Meshtastic-Malaysia/russell/README.md

# Russell

Russell is a board designed to mount on an ER34615/IFR32700 cell and go Up! on a balloon.

- RAK3172 STM32WLE5CCU6 MCU + integrated SX1262 LoRa
- CDtop CD-PA1010D GPS
- Bosch Sensortec BME280 sensor
- Consonance CN3158 LiFePO4 solar charger
