Meshtastic-Malaysia/russell/3dmodels/SHOU HAN TS36CA-0.6_v1.step

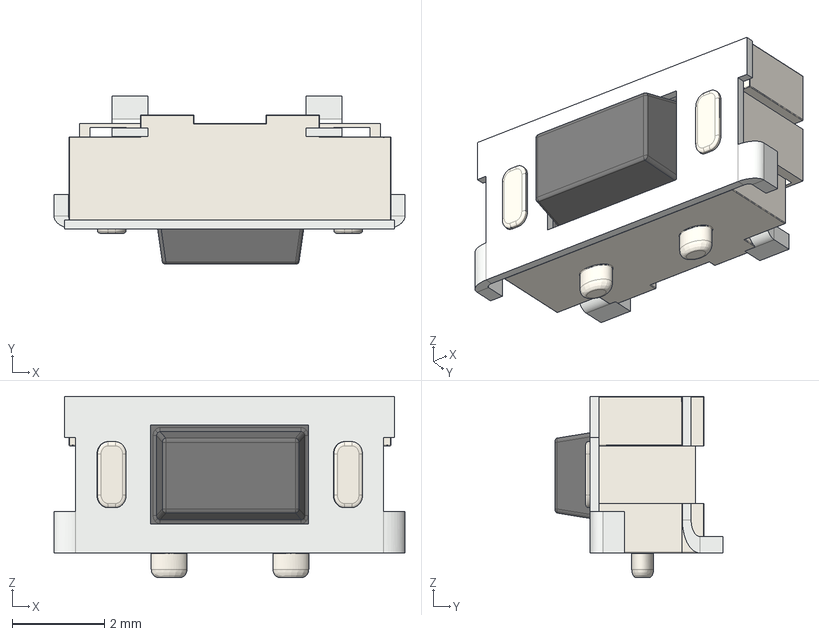
[picture p1: CAD file, 2025-12-26]
3dmodels/SHOU HAN TS36CA-0.6_v1.step
7.60 x 3.64 x 3.93 mm
xiaobeibei_body
xiaobeibei_cap
xiaobeibei_plate
xiaobeibei_pin x 2
