Meshtastic-Malaysia/russell/3dmodels/CD-PA1010D--3DModel-STEP-271329.STEP

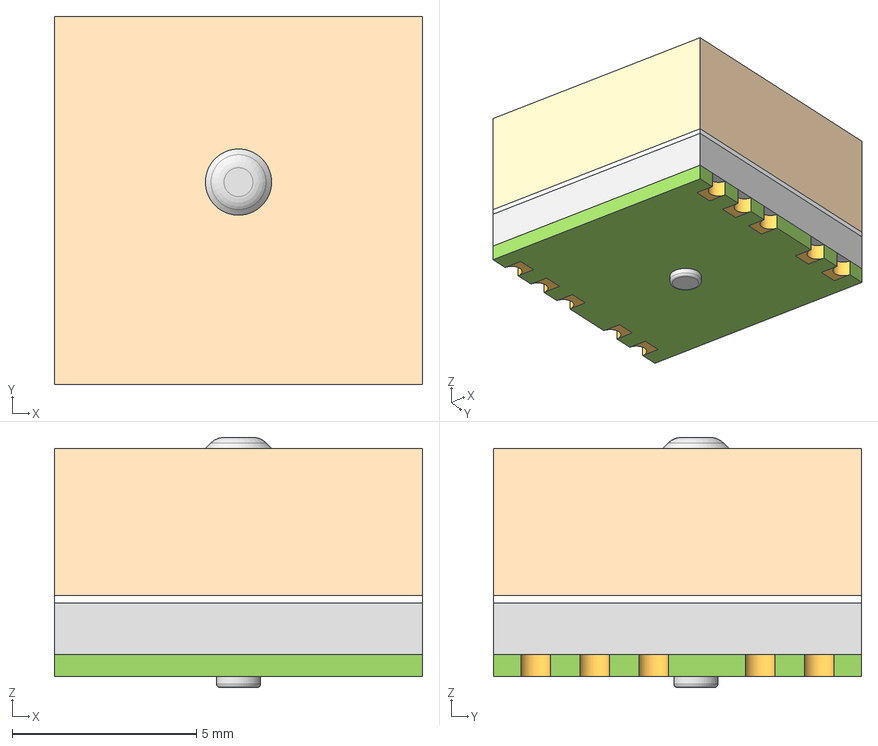
[picture p3: CAD file, 2025-12-26]
3dmodels/CD-PA1010D--3DModel-STEP-271329.STEP
10.0 x 10.0 x 6.80 mm
AntennaBottom
AntennaTop
BlockUp
Glue
BlockBottom
PCB
Pads
