Meshtastic-Malaysia/russell/3dmodels/1TS003B.step

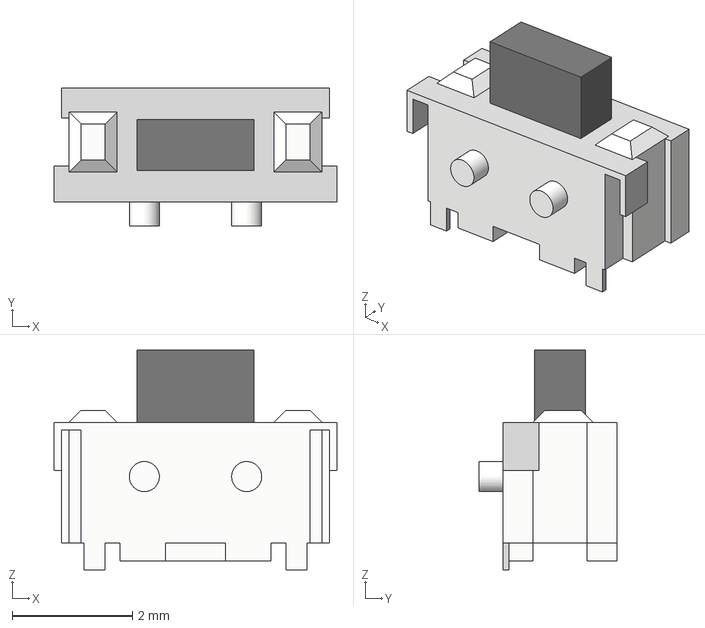
[picture p4: CAD file, 2025-12-26]
3dmodels/1TS003B.step
4.70 x 2.30 x 3.65 mm
