Meshtastic-Malaysia/russell/russell.kicad_pcb

## KiCad design russell.kicad_pcb (2025-12-26)

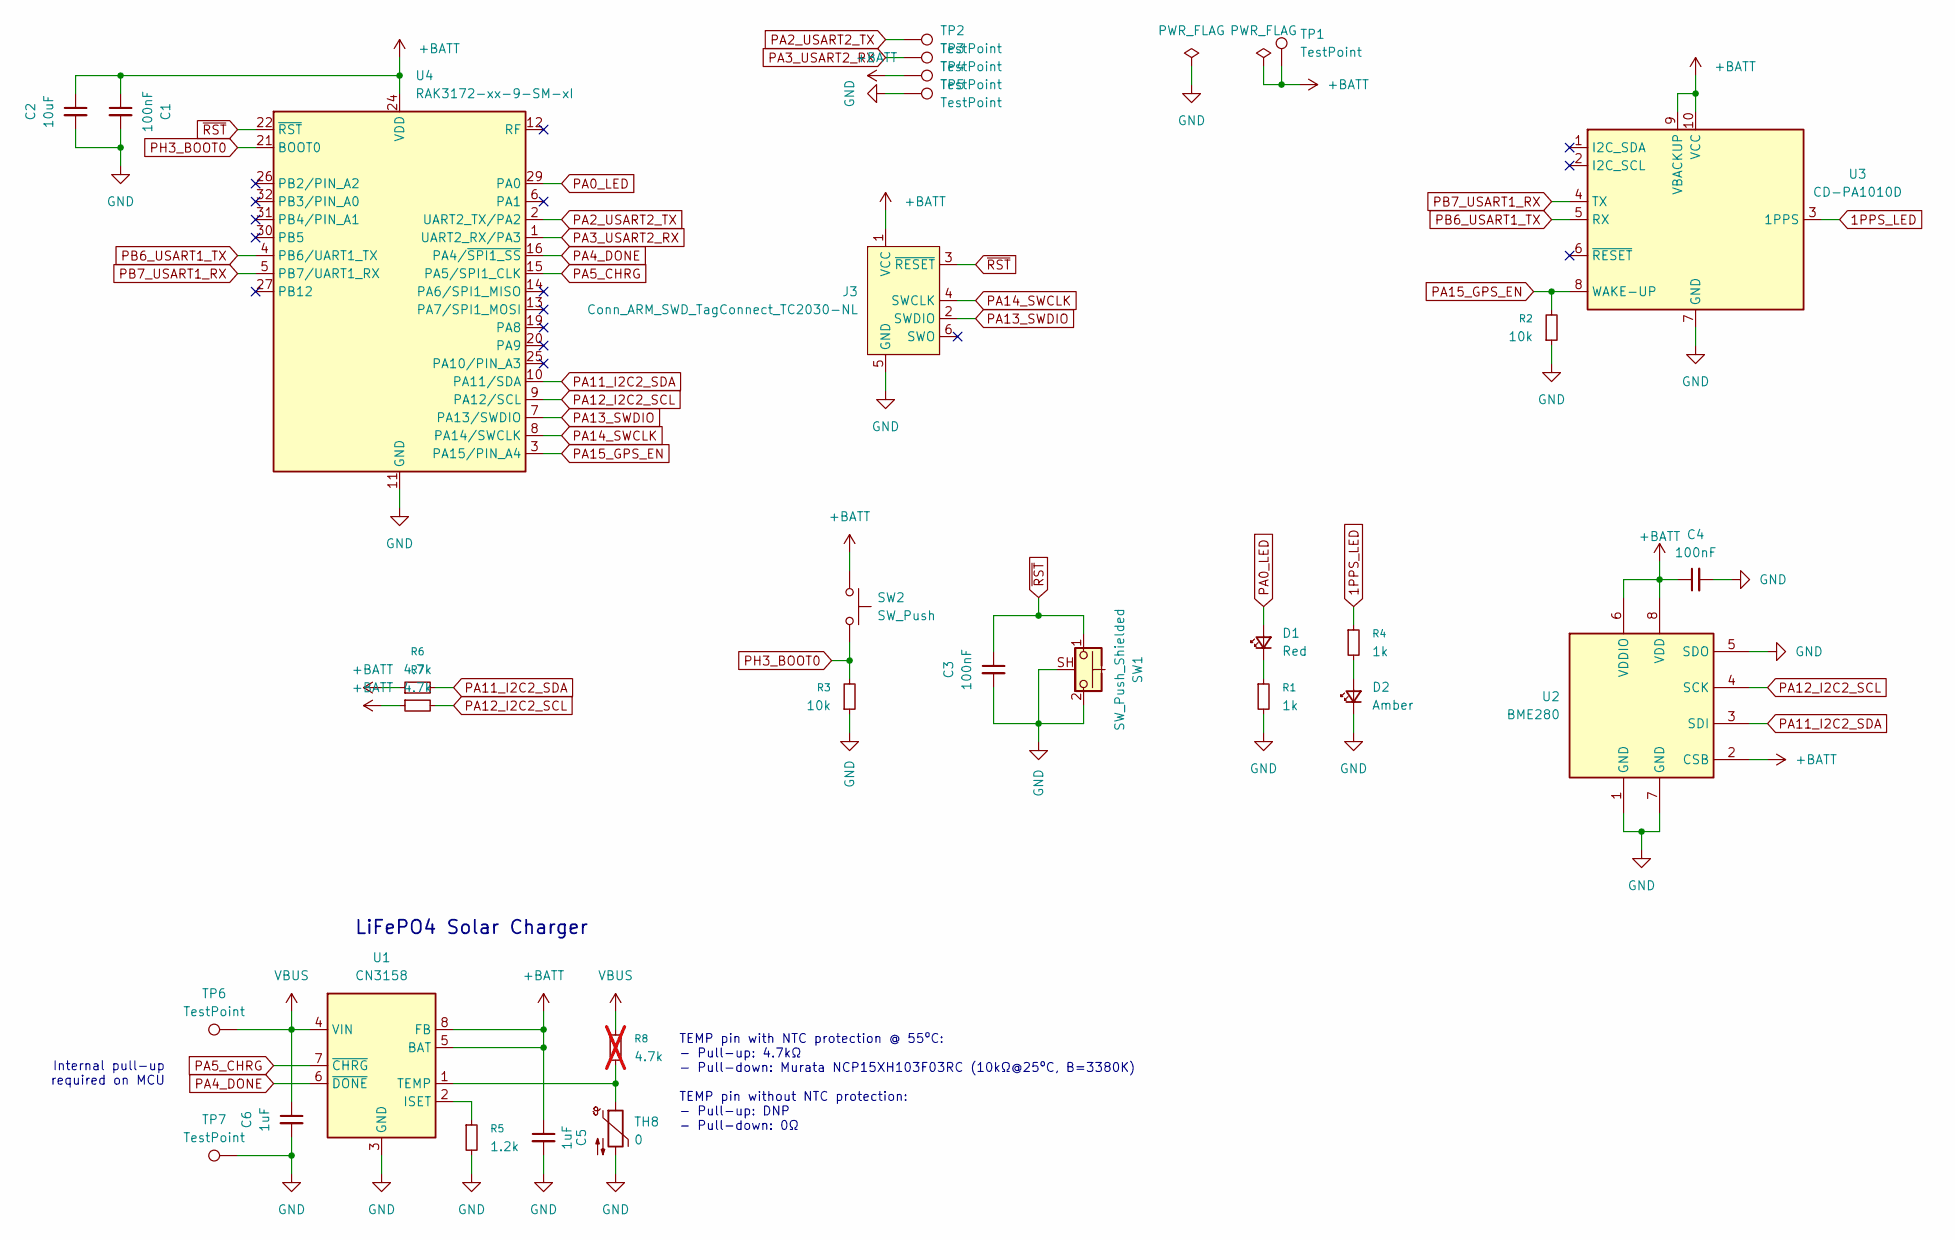
[picture p5: schematic russell.kicad_sch]

Parts:
C1, C3, C4: 100nF; C_0402_1005Metric; LCSC C1525
C2: 10uF; C_0402_1005Metric; LCSC C15525
C5: 1uF; LCSC C52923
C6: 1uF; C_0402_1005Metric; LCSC C52923
D1: Red; LED_0603_1608Metric; LCSC C2286
D2: Amber; LED_0603_1608Metric; LCSC C89811
J3: Conn_ARM_SWD_TagConnect_TC2030-NL; Tag-Connect_TC2030-IDC-NL_2x03_P1.27mm_Vertical
R1, R4: 1k; R_0402_1005Metric; LCSC C11702
R2, R3: 10k; R_0402_1005Metric; LCSC C25744
R5: 1.2k; R_0402_1005Metric; LCSC C25862
R6, R7: 4.7k; R_0402_1005Metric; LCSC C25900
R8: 4.7k; R_0402_1005Metric; LCSC C25900; not fitted
SW1: SW_Push_Shielded; SW_SPST_Shouhan_TS24CA; LCSC C5373430
SW2: SW_Push; SW_SPST_TS-1088-xR020; LCSC C720477
TH8: 0; R_0402_1005Metric; LCSC C17168
TP1: TestPoint; TestPoint_Pad_D4.0mm
TP2, TP3, TP5, TP7: TestPoint; TestPoint_Pad_D1.0mm
TP4, TP6: TestPoint; TestPoint_Pad_1.0x1.0mm
U1: CN3158; SOIC-8-1EP_3.9x4.9mm_P1.27mm_EP2.41x3.3mm_ThermalVias; LCSC C559032
U2: BME280; Bosch_LGA-8_2.5x2.5mm_P0.65mm_ClockwisePinNumbering; LCSC C92489
U3: CD-PA1010D; CDTop_CD-PA1010; LCSC C9900050424
U4: RAK3172-xx-9-SM-xI; RAK3172; LCSC C19723909

Connections:
1PPS_LED: R4.1, U3.3 (1PPS)
+BATT: C1.1, C2.1, C4.1, C5.1, J3.1 (VCC), R6.1, R7.1, SW2.1, TP1.1, TP4.1, U1.5 (BAT), U1.8 (FB), U2.2 (CSB), U2.6 (VDDIO), U2.8 (VDD), U3.9 (VBACKUP), U3.10 (VCC), U4.24 (VDD)
GND: C1.2, C2.2, C3.2, C4.2, C5.2, C6.2, D2.1 (K), J3.5 (GND), R1.2, R2.1, R3.1, R5.2, SW1.2, SW1.SH (B), TH8.2, TP5.1, TP7.1, U1.3 (GND), U1.9 (GND), U2.1 (GND), U2.5 (SDO), U2.7 (GND), U3.7 (GND), U4.11 (GND), U4.17 (GND), U4.18 (GND), U4.23 (GND), U4.28 (GND)
unnamed: D1.1 (K), R1.1
unnamed: D2.2 (A), R4.2
unnamed: R5.1, U1.2 (ISET)
unnamed: R8.2, TH8.1, U1.1 (TEMP)
PA0_LED: D1.2 (A), U4.29 (PA0)
PA2_USART2_TX: TP2.1, U4.2 (UART2_TX/PA2)
PA3_USART2_RX: TP3.1, U4.1 (UART2_RX/PA3)
PA4_DONE: U1.6 (~DONE), U4.16 (PA4/~SPI1_SS)
PA5_CHRG: U1.7 (~CHRG), U4.15 (PA5/SPI1_CLK)
PA11_I2C2_SDA: R6.2, U2.3 (SDI), U4.10 (PA11/SDA)
PA12_I2C2_SCL: R7.2, U2.4 (SCK), U4.9 (PA12/SCL)
PA13_SWDIO: J3.2 (SWDIO), U4.7 (PA13/SWDIO)
PA14_SWCLK: J3.4 (SWCLK), U4.8 (PA14/SWCLK)
PA15_GPS_EN: R2.2, U3.8 (WAKE-UP), U4.3 (PA15/PIN_A4)
PB6_USART1_TX: U3.5 (RX), U4.4 (PB6/UART1_TX)
PB7_USART1_RX: U3.4 (TX), U4.5 (PB7/UART1_RX)
PH3_BOOT0: R3.2, SW2.2, U4.21 (BOOT0)
VBUS: C6.1, R8.1, TP6.1, U1.4 (VIN)
~RST: C3.1, J3.3 (~RESET), SW1.1, U4.22 (~RST)

Notes on the sheet:
Internal pull-up required on MCU
LiFePO4 Solar Charger
TEMP pin with NTC protection @ 55ºC: - Pull-up: 4.7kΩ - Pull-down: Murata NCP15XH103F03RC (10kΩ@25ºC, B=3380K) TEMP pin without NTC protection: - Pull-up: DNP - Pull-down: 0Ω

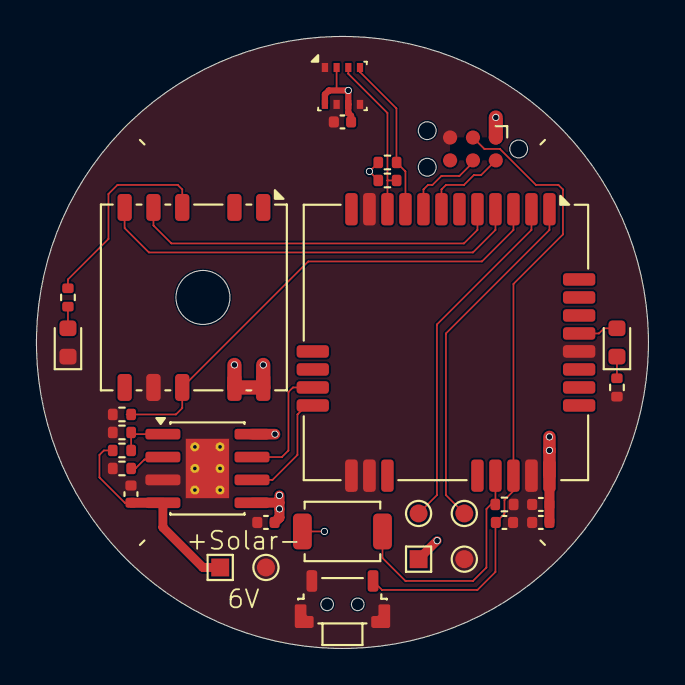
[picture p6: board russell.kicad_pcb from above]

Board: 2 copper layers, 34.0 x 34.0 mm, 31 parts (1 on the bottom side), 22 nets.
